OisinS13/PD_Sink_Prototyping_Board/Hand_solder/USB_C_PD_Prototyping_Board_hand_solder.pdf

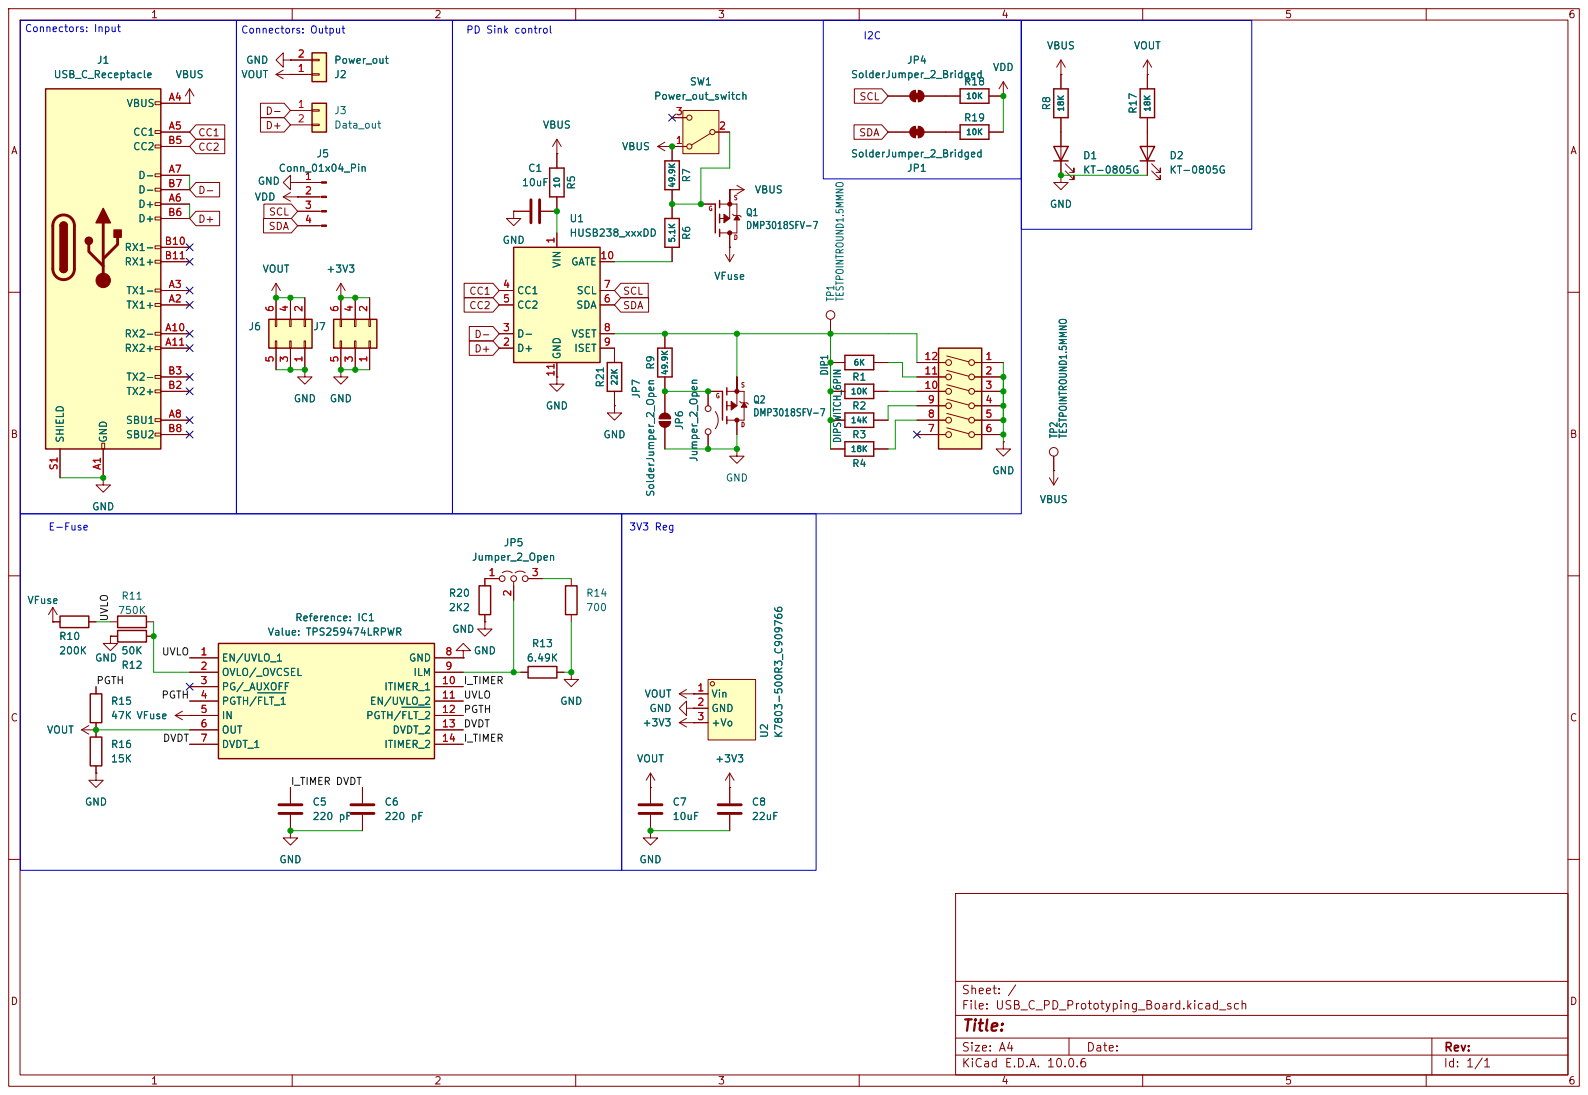
[picture p3: page 1]

Size: A4 | Rev:
KiCad E.D.A. 10.0.6 | Id: 1/1
