OisinS13/PD_Sink_Prototyping_Board/Hand_solder/Images/Schematic.pdf

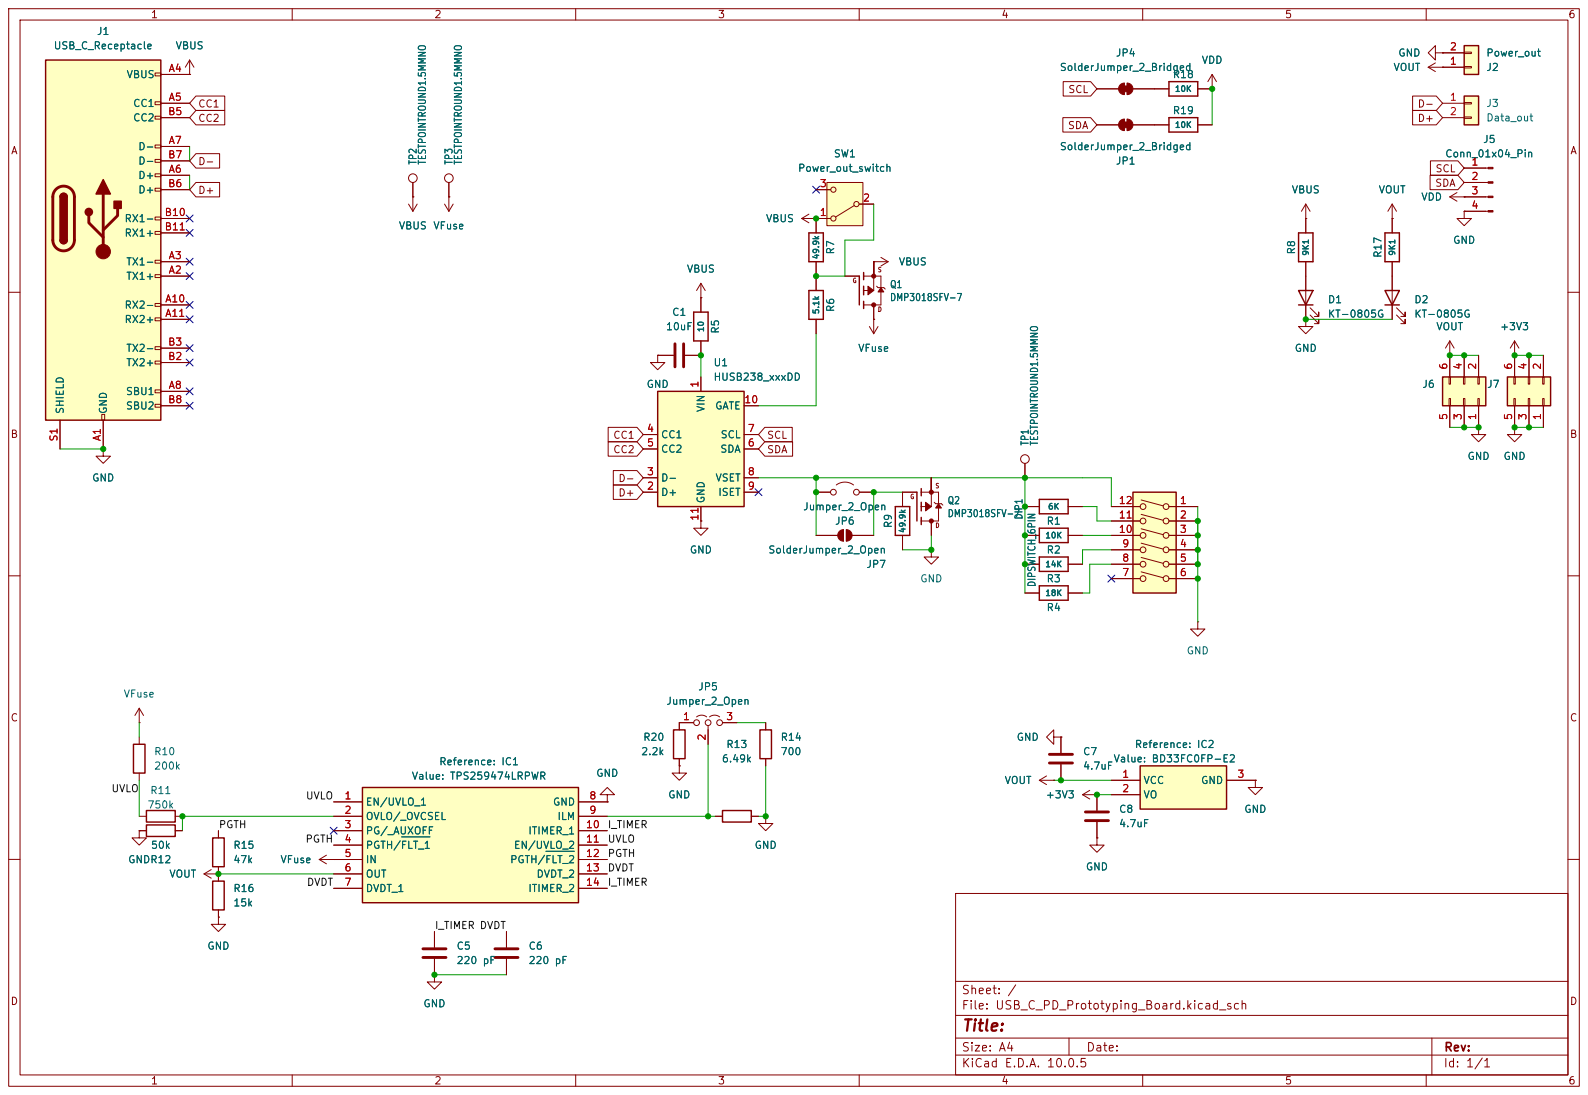
[picture p4: page 1]

8 8 | 5 5
7 7 | 6 6

Size: A4 | Rev:
KiCad E.D.A. 10.0.5 | Id: 1/1
