OisinS13/PD_Sink_Prototyping_Board/USB_C_PD_Prototyping_Board.kicad_pcb

## KiCad design USB_C_PD_Prototyping_Board.kicad_pcb (2026-09-23)

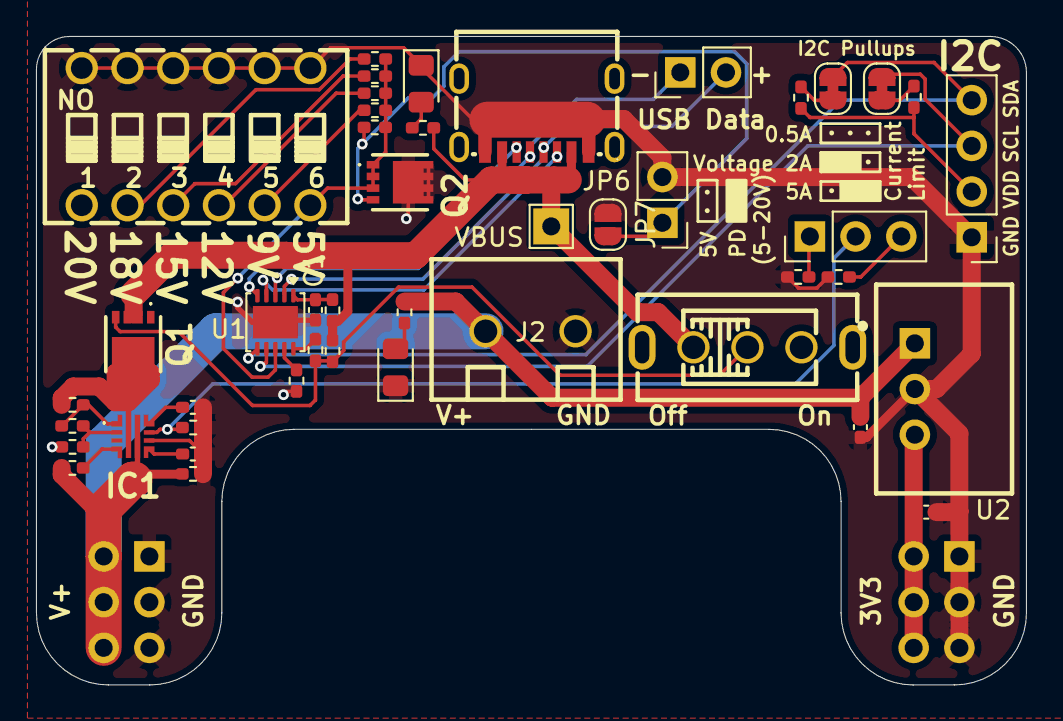
[picture p5: board USB_C_PD_Prototyping_Board.kicad_pcb from above]

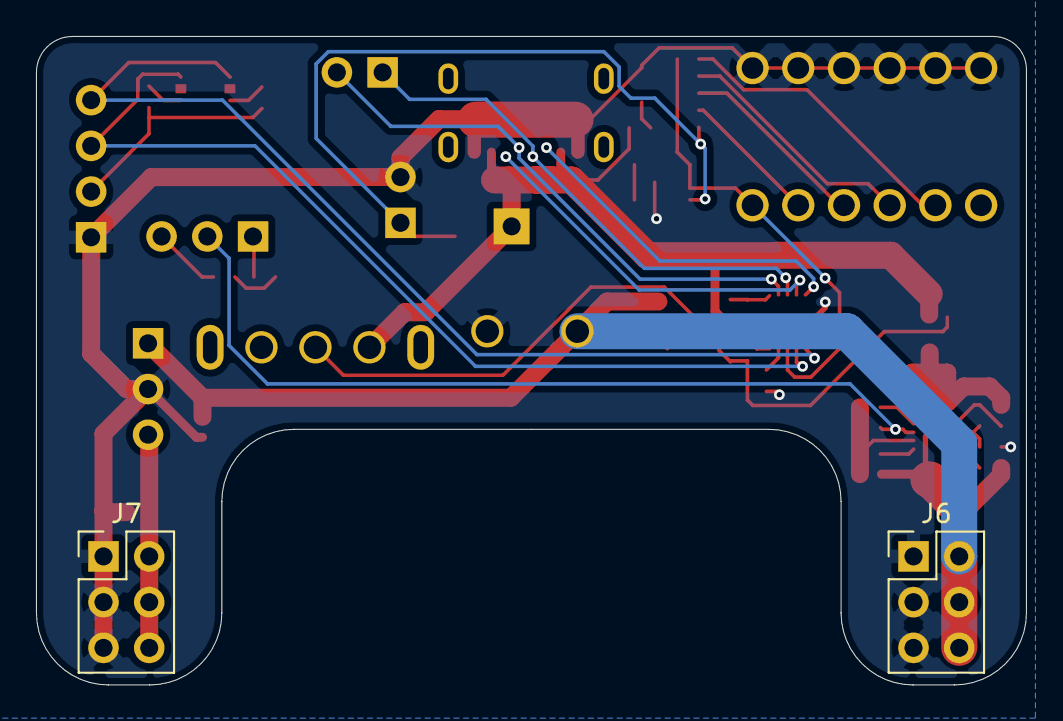
[picture p6: board USB_C_PD_Prototyping_Board.kicad_pcb from below]

Board: 2 copper layers, 55.0 x 36.0 mm, 47 parts (2 on the bottom side), 34 nets.

Parts:
C1, C7: 10uF; C_0402_1005Metric_Pad0.74x0.62mm_HandSolder
C5, C6: 220 pF; C_0402_1005Metric_Pad0.74x0.62mm_HandSolder
C8: 22uF; C_0402_1005Metric_Pad0.74x0.62mm_HandSolder
D1, D2: KT-0805G; LED_0805_2012Metric_Pad1.15x1.40mm_HandSolder
DIP1: DIPSWITCH_6PIN; SW-TH_DSWB06LHGET
IC1: TPS259474LRPWR
J1: USB_C_Receptacle; USB-TYPE-C-SMD_MC-403L68-Z10
J2: Power_out; CONN-TH_2P-P5.00_MX126-5.0-GN01-02P-CU-S-A
J3: Data_out; PinHeader_1x02_P2.54mm_Vertical
J5: Conn_01x04_Pin; PinHeader_1x04_P2.54mm_Vertical
J6, J7: Conn_02x02_Counter_Clockwise; PinHeader_2x03_P2.54mm_Vertical
JP1, JP4: SolderJumper_2_Bridged; SolderJumper-2_P1.3mm_Bridged_RoundedPad1.0x1.5mm
JP5: Jumper_2_Open; PinHeader_1x03_P2.54mm_Vertical
JP6: Jumper_2_Open; PinHeader_1x02_P2.54mm_Vertical
JP7: SolderJumper_2_Open; SolderJumper-2_P1.3mm_Open_RoundedPad1.0x1.5mm
Q1, Q2: DMP3018SFV-7; DMP3036SFV7
R1: 6K; R_0402_1005Metric_Pad0.72x0.64mm_HandSolder
R2, R18, R19: 10K; R_0402_1005Metric_Pad0.72x0.64mm_HandSolder
R3: 14K; R_0402_1005Metric_Pad0.72x0.64mm_HandSolder
R4, R8, R17: 18K; R_0402_1005Metric_Pad0.72x0.64mm_HandSolder
R5: 10; R_0402_1005Metric_Pad0.72x0.64mm_HandSolder
R6: 5.1K; R_0402_1005Metric_Pad0.72x0.64mm_HandSolder
R7, R9: 49.9K; R_0402_1005Metric_Pad0.72x0.64mm_HandSolder
R10: 200K; R_0402_1005Metric_Pad0.72x0.64mm_HandSolder
R11: 750K; R_0402_1005Metric_Pad0.72x0.64mm_HandSolder
R12: 50K; R_0402_1005Metric_Pad0.72x0.64mm_HandSolder
R13: 6.49K; R_0402_1005Metric_Pad0.72x0.64mm_HandSolder
R14: 700; R_0402_1005Metric_Pad0.72x0.64mm_HandSolder
R15: 47K; R_0402_1005Metric_Pad0.72x0.64mm_HandSolder
R16: 15K; R_0402_1005Metric_Pad0.72x0.64mm_HandSolder
R20: 2K2; R_0402_1005Metric_Pad0.72x0.64mm_HandSolder
R21: 22K; R_0402_1005Metric_Pad0.72x0.64mm_HandSolder
SW1: Power_out_switch; SW-TH_SS-12F44-G5_C2998807
TP2: TESTPOINTROUND1.5MMNO; TestPoint_THTPad_2.0x2.0mm_Drill1.0mm
U1: HUSB238_xxxDD; WDFN-10-1EP_3x3mm_P0.5mm_EP1.8x2.5mm
U2: K7803-500R3_C909766; PWRM-TH_K78XX-500R3

Connections:
+3V3: C8.2, J7.2, J7.4, J7.6, U2.3 (+Vo)
/DVDT: C6.2, IC1.7 (DVDT_1), IC1.13 (DVDT_2)
/I_TIMER: C5.2, IC1.10 (ITIMER_1), IC1.14 (ITIMER_2)
/PGTH: IC1.4 (PGTH/~FLT_1), IC1.12 (PGTH/~FLT_2), R15.1
/UVLO: IC1.1 (EN/UVLO_1), IC1.11 (EN/UVLO_2), R10.1, R11.1
CC1: J1.A5 (CC1), U1.4 (CC1)
CC2: J1.B5 (CC2), U1.5 (CC2)
D+: J1.A6 (D+), J3.2, U1.2 (D+)
D-: J1.A7 (D-), J3.1, U1.3 (D-)
GND: C1.1, C5.1, C6.1, C7.1, C8.1, D1.1 (K), D2.1 (K), DIP1.1, DIP1.2, DIP1.3, DIP1.4, DIP1.5, DIP1.6, IC1.8 (GND), J1.B1 (GND), J1.B12 (GND), J2.2, J5.1, J6.1, J6.3, J6.5, J7.1, J7.3, J7.5, JP6.2 (B), JP7.2 (B), Q2.5, R12.1, R13.1, R14.2, R16.2, R20.2, R21.1, U1.11 (GND), U2.2 (GND)
unnamed: D1.2 (A), R8.1
unnamed: D2.2 (A), R17.1
unnamed: DIP1.8, R4.1
unnamed: DIP1.9, R3.1
unnamed: DIP1.10, R2.1
unnamed: DIP1.11, R1.1
unnamed: IC1.9 (ILM), JP5.2 (C), R13.2
unnamed: IC1.2 (OVLO/_OVCSEL), R11.2, R12.2
unnamed: JP1.2 (B), R19.1
unnamed: JP4.2 (B), R18.1
unnamed: JP5.1 (A), R20.1
unnamed: JP5.3 (B), R14.1
unnamed: JP6.1 (A), JP7.1 (A), Q2.4 (G), R9.1
unnamed: Q1.4 (G), R6.1, R7.2, SW1.2 (B)
unnamed: R6.2, U1.10 (GATE)
unnamed: R21.2, U1.9 (ISET)
unnamed: C1.2, R5.2, U1.1 (VIN)
unnamed: DIP1.12, Q2.1 (S), Q2.2 (S), Q2.3 (S), R1.2, R2.2, R3.2, R4.2, R9.2, U1.8 (VSET)
SCL: J5.3, JP4.1 (A), U1.7 (SCL)
SDA: J5.4, JP1.1 (A), U1.6 (SDA)
VBUS: J1.B4 (VBUS), J1.B9 (VBUS), Q1.2 (S), Q1.3 (S), R5.1, R7.1, R8.2, SW1.1 (A), TP2.1 (1_1)
VDD: J5.2, R18.2, R19.2
VFuse: IC1.5 (IN), Q1.5, R10.2
VOUT: C7.2, IC1.6 (OUT), J2.1, J6.2, J6.4, J6.6, R15.2, R16.1, R17.2, U2.1 (Vin)
