OisinS13/PD_Sink_Prototyping_Board/Hand_solder/Images/Layout.png

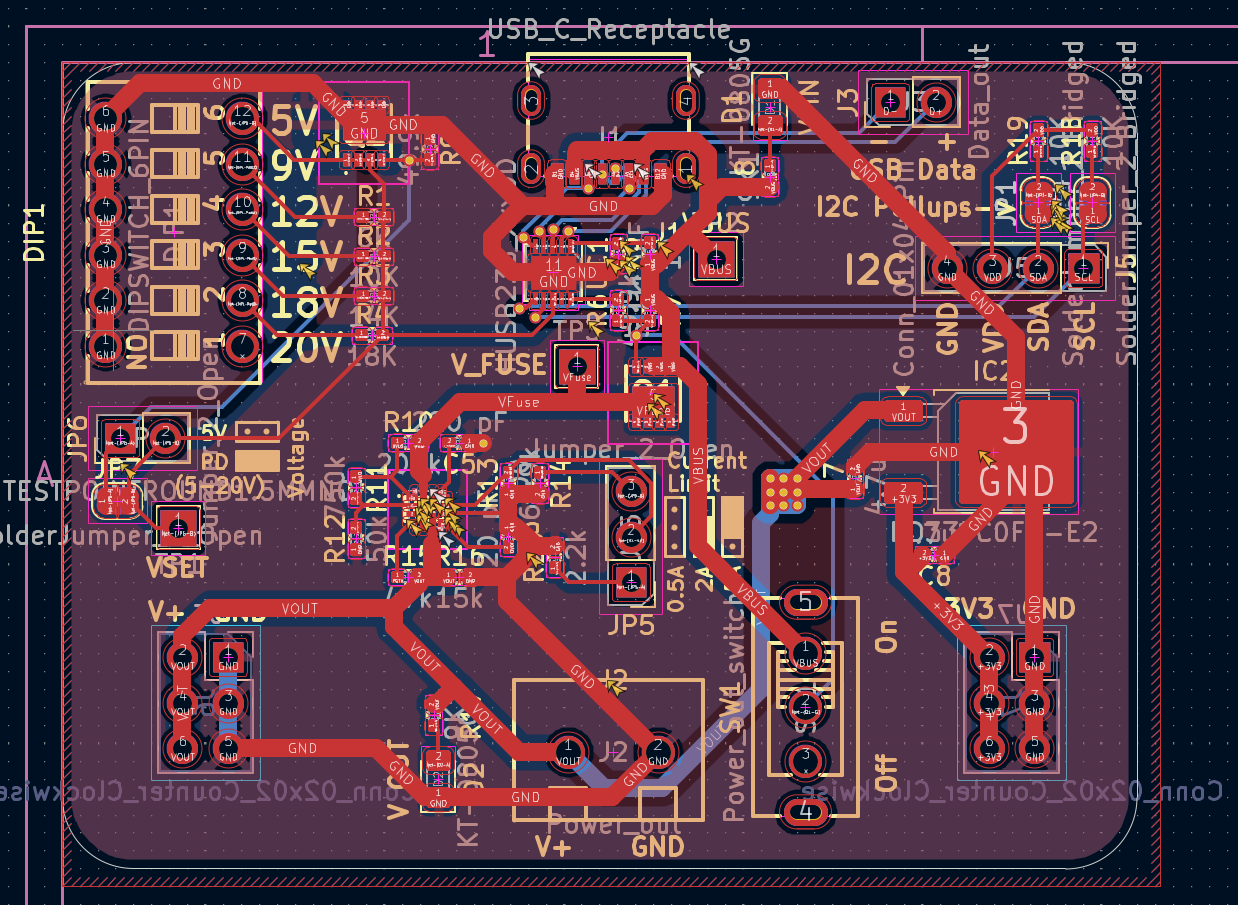
Hand_solder/Images/Layout.png
