OisinS13/PD_Sink_Prototyping_Board/Hand_solder/Images/USB_C_PD_Prototyping_Board_hand_solder.png

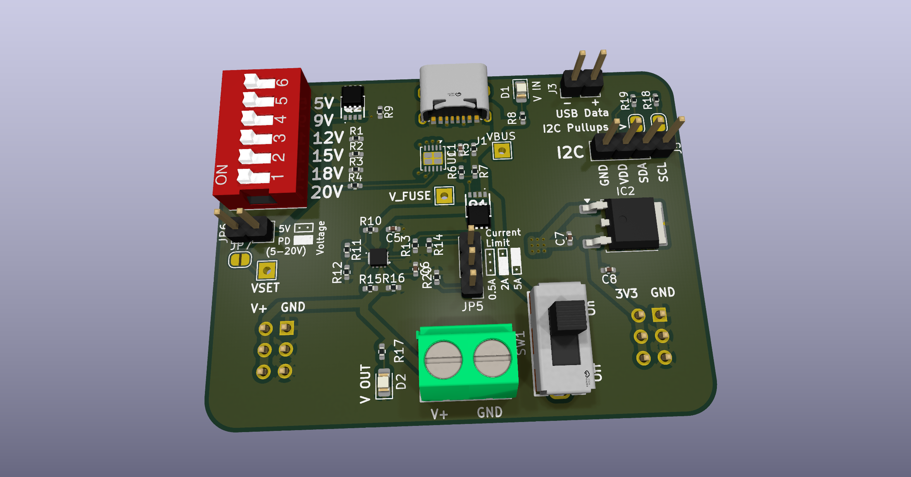
Hand_solder/Images/USB_C_PD_Prototyping_Board_hand_solder.png
