OisinS13/PD_Sink_Prototyping_Board/(commit log)

2026-09-16 Initial Prototype
    [USB_C_PD_Prototyping_Board-B_Cu.gbr, USB_C_PD_Prototyping_Board-B_Mask.gbr, USB_C_PD_Prototyping_Board-B_Paste.gbr, USB_C_PD_Prototyping_Board-B_Silkscreen.gbr, USB_C_PD_Prototyping_Board-Edge_Cuts.gbr, USB_C_PD_Prototyping_Board-F_Cu.gbr, USB_C_PD_Prototyping_Board-F_Mask.gbr, USB_C_PD_Prototyping_Board-F_Paste.gbr]
2026-09-21 Re-worked after initial tests
    - Corrected silkscreen labels for output switch
    - Corrected jumper logic polarity for voltage select
    - Added ISET resistor to set default current request to 3A (instead of 3.25A for open circuit) so that 9, 12V selectable with DIP switches
    - Double indicator LED limiting resistor values to reduce brightness
    - Changed 3V3 reg to switch mode to solve thermals
    - Added cutout to limit covering of breadboard rows
    - Made as many resistors as possible THT to use as a soldering task (will spin up an SMD only one as a cheaper out of the box solution too)
    - Simplified and thickened primary current path (there wasn't a problem, but it will be more capable now)
    [USB_C_PD_Prototyping_Board.kicad_pcb, USB_C_PD_Prototyping_Board.kicad_sch]
2026-09-23 Seperate hand solder and ready to use versions
    [USB_C_PD_Prototyping_Board.kicad_pcb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]
